whosthedoctor/Open-Source-Chemical-Reactor/docs/cube-face-template-gasket.png

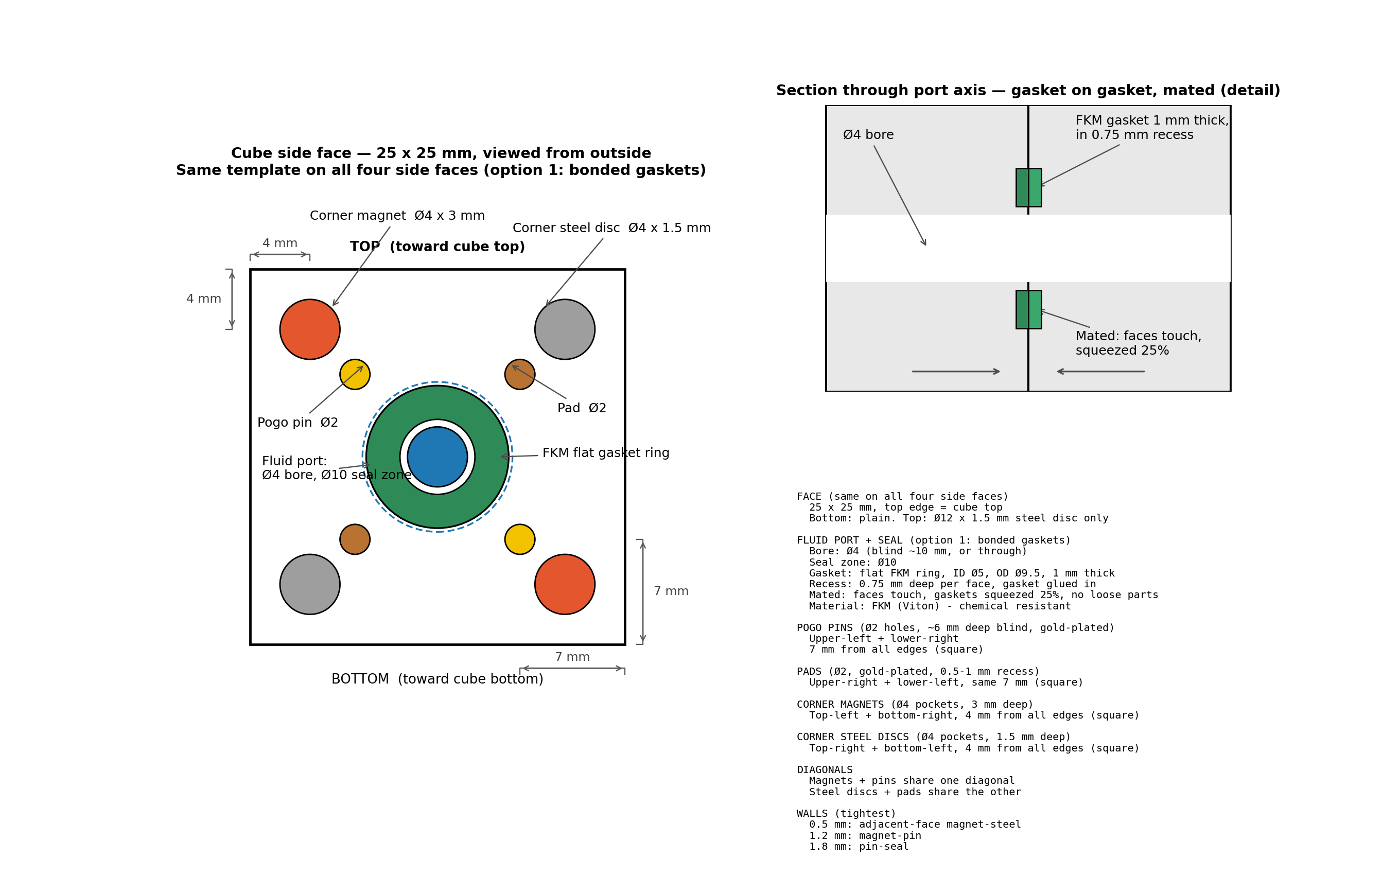
docs/cube-face-template-gasket.png
