whosthedoctor/Open-Source-Chemical-Reactor/BOM.csv

component | quantity | unit_price_usd | link | notes
Ender 3 (used - motion gantry) | 1 | 0.00 | https://www.ebay.com/sch/i.html?_nkw=creality+ender+3 | ALREADY OWNED (confirmed Oct 2026) - $200 if you need to buy one. PSU is included with the printer, no separate PSU needed
Bambu Lab PETG Translucent filament (cube structure) | 2 | 18.99 | https://www.bestbuy.com/product/bambu-lab-1-75mm-petg-translucent-filament-clear/CZTZV9ZPZH/sku/6610619 | Price at Best Buy checked Oct 2026
Spring-loaded pogo pins gold-plated (pack of 100) | 1 | 15.00 | https://www.amazon.com/s?k=gold+spring+loaded+pogo+pins | Power/signal interconnects between cubes
Neodymium disc magnets (pack of 100) | 1 | 15.00 | https://www.amazon.com/s?k=small+neodymium+disc+magnets | Self-aligning cube snap
PTFE tubing 2mm ID x 4mm OD 5m (wetted fluid path + bore sleeves) | 1 | 15.00 | https://www.amazon.com/s?k=ptfe+tubing+2mm+id | 2mm ID x 4mm OD. One sleeve per fluid bore, cut flush at the face: 10mm for a blind bore, 25mm for a through bore. 5m covers sleeves for 20 cubes plus pump/valve plumbing
FKM O-ring 5 x 1.5mm (fluid face seals) | 1 | 11.00 | https://oringsandmore.com/fkm-o-ring-5-x-1-5mm-minimum-15-pcs/ | 75-durometer FKM (OringsandMore SKU 515MMV), min 15 pcs: $1.05 + $9.95 USPS First Class = $11.00 delivered; one ring per mated pair, groove ID 5.5mm / OD 9.5mm, 0.6mm deep per face; price/shipping from product page Oct 2026, re-confirm at checkout
Peltier modules TEC1-12706 (Peltier cubes) | 4 | 7.50 | https://www.amazon.com/s?k=tec1-12706 | 12V part - driven via MOSFET module from dedicated 24V->12V buck rail (hybrid rail decision 2026-10-24); HB output unused for Peltier
Heater cartridges 24V 40W 6x20mm ceramic (heater cubes) | 1 | 15.49 | https://www.walmart.com/ip/16147002771 | Pack of 6 (5 needed + 1 spare) - 24V cartridges match HE0/HE1 at 24V VIN, no buck needed for heaters (hybrid rail decision 2026-10-24)
NTC 100K thermistors for heater cubes | 1 | 6.00 | https://www.amazon.com/s?k=100k+ntc+thermistor+3950 | Estimate - heater cube temperature sensing (TH0/TH1)
24V to 12V buck converter 10A with fuse (Peltier rail) | 1 | 16.79 | https://www.walmart.com/ip/18121103298 | Dedicated 12V rail for the Peltier only - sized for one Peltier cube at a time (6A max draw)
MOSFET trigger switch modules (Peltier + valves/vacuum/LEDs) | 1 | 8.69 | https://www.walmart.com/ip/17434554288 | Pack of 4 - logic-level PC13/EXP pins switch 12V loads; covers Peltier + all valve/LED outputs
12V DC peristaltic dosing pumps | 2 | 10.00 | https://www.amazon.com/s?k=12v+peristaltic+dosing+pump | Run from CNC fan outputs jumpered to 12V (1A/port max, 2.5A total)
12V 2-way solenoid valves (fluid routing) | 2 | 9.00 | https://www.amazon.com/s?k=12v+2-way+solenoid+valve | Driven via EXP logic pins + external MOSFET module (only 2 CNC fan outputs on M5P)
pH probe + DS18B20 temp probes + calibration buffers (sensor cube) | 1 | 40.00 | https://www.amazon.com/s?k=ph+probe+module+ds18b20+calibration+buffer | Sold as a kit
BIGTREETECH Manta M5P V1.0 mainboard (5-axis - Klipper) | 1 | 52.99 | https://west3d.com/products/btt-manta-m5p-klipper-controller-board-3d-printer-control-system-using-cb1-cm4 | Board only - drivers separate. CNC fan outputs jumper-selectable 5/12/24V (manual-verified)
TMC2209 stepper drivers | 5 | 9.00 | https://www.amazon.com/s?k=tmc2209+stepper+driver | X/Y/Z + grabber rotate + grabber lift
BIGTREETECH CB1 (Klipper host - mounts on M5P) | 1 | 53.89 | https://www.newegg.com/p/3C6-037R-00035 | Host confirmed 2026-10-24 - M5P requires a CM4-form-factor host on the BTB headers
uxcell 605ZZ bearings 5x14x5mm (pack of 20) | 1 | 9.00 | https://www.amazon.com/s?k=uxcell+605ZZ+5x14x5mm+pack+of+20 | Price estimate - verify at checkout; exact 20-pack not price-verified (5-pack found at $10.49)
BNTECHGO 28 AWG silicone wire red/black 50ft | 1 | 21.64 | https://mastergripshop.com/products/b07hgt77r5 | Signal/sensor/endstop wiring ONLY - too thin for heater/Peltier power runs
Silicone wire 18 AWG for heater/Peltier power runs | 1 | 12.00 | https://www.amazon.com/s?k=18+awg+silicone+wire+red+black | Estimate - 28 AWG cannot carry 3.3A+ heater currents
HESAI mechanical endstop switches with cable (pack of 6) | 1 | 12.00 | https://www.amazon.com/s?k=HESAI+3D+printer+endstop+limit+switch+pack+of+6 | Price estimate - verify; X/Y/Z endstops + spares
STEPPERONLINE NEMA 11 stepper motor 0.67A (grabber motors) | 2 | 11.32 | https://s.click.aliexpress.com/deep_link.htm | Catalog variant is 7Ncm; your spec is 6Ncm/8.5oz-in - confirm shaft/variant
Head magnet - disc magnet 14mm x 3mm (pack of 20) | 1 | 16.99 | https://themagnetbaron.com/products/20pcs-5-8-x-1-8-14mm-x-3mm-disc-magnets?variant=30753395310676 | Magnet head - 1 needed, 19 spares
Corner magnets - disc magnet 4mm x 3mm (pack of 100) | 1 | 16.99 | https://wargameportal.com/products/100pcs-4mm-x-3mm-5-32-x-1-8-disc-magnets?variant=49647373320470 | 2 per cube (diagonal) - 40 for 20 cubes + spares
Cube-top steel discs 12mm x 1.5mm (pack of 20) | 1 | 9.00 | https://www.amazon.com/s?k=steel+disc+12mm | Estimate - verify; 1 per cube - magnet-head pickup target
Corner steel discs 4mm x 1.5mm (pack of 100) | 1 | 8.00 | https://www.amazon.com/s?k=steel+disc+4mm | Estimate - verify; 2 per cube (diagonal, opposite the corner magnets)
TMC2209 stepper drivers (spares) | 2 | 9.00 | https://www.amazon.com/s?k=tmc2209+stepper+driver | Spare drivers - a shorted motor wire kills a driver; 5 in use, 2 spares
Peltier module TEC1-12706 (spare) | 1 | 7.50 | https://www.amazon.com/s?k=tec1-12706 | Spare Peltier - thermal-cycling failures; 4 in use
2-part epoxy syringe (sleeve retention) | 1 | 7.00 | https://www.amazon.com/s?k=2+part+epoxy+syringe | Estimate - verify. Dab on the sleeve OD at the inner end, inside the cube and out of the fluid path; also usable for potting face magnets
Shipping (consolidated estimate across vendors) | 1 | 35.00 |  | Stardance requires prices including shipping - TOTAL: $596.59 (Ender 3 already owned; host = CB1; hybrid heater rail: 24V cartridges + 12V Peltier on buck/MOSFET; magnet head; includes spares: 2x TMC2209 + 1x Peltier; PTFE bore sleeves + epoxy; FKM seal line booked at $11.00 delivered - if that $9.95 OringsandMore shipping is already inside this $35 estimate | total is $586.64)
