whosthedoctor/Open-Source-Chemical-Reactor/CAD/6-way_connector.step

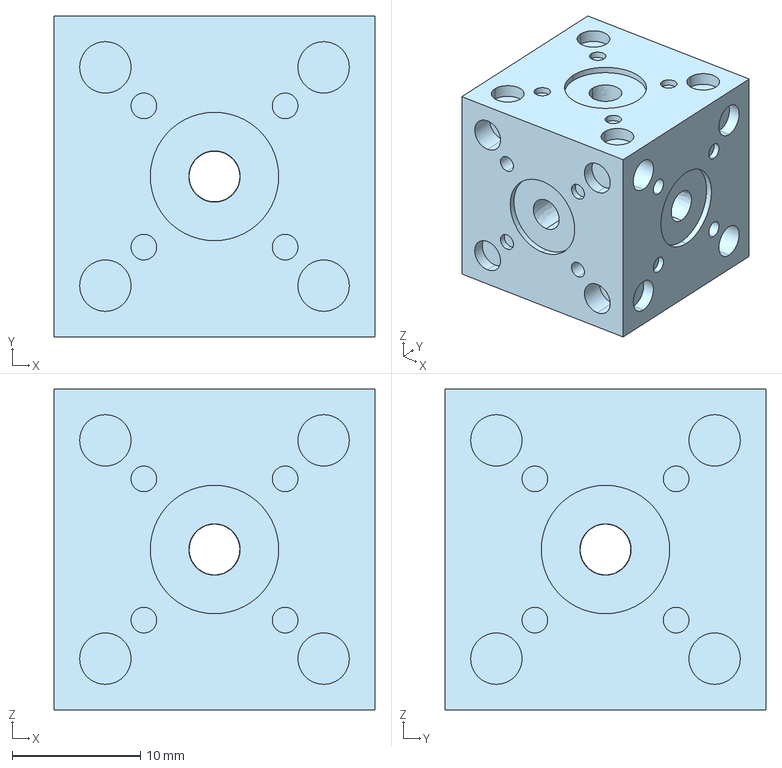
[picture p3: CAD file, 2026-10-27]
CAD/6-way_connector.step
25.0 x 25.0 x 25.0 mm
