whosthedoctor/Open-Source-Chemical-Reactor/CAD/Hotbed_Steel_Disc_Cover.step

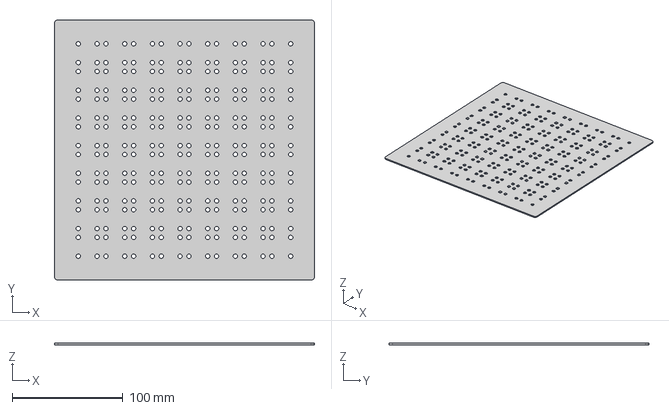
[picture p4: CAD file, 2026-10-27]
CAD/Hotbed_Steel_Disc_Cover.step
235.0 x 235.0 x 1.50 mm
