whosthedoctor/Open-Source-Chemical-Reactor/CAD/carriage grabber - Part 9.step

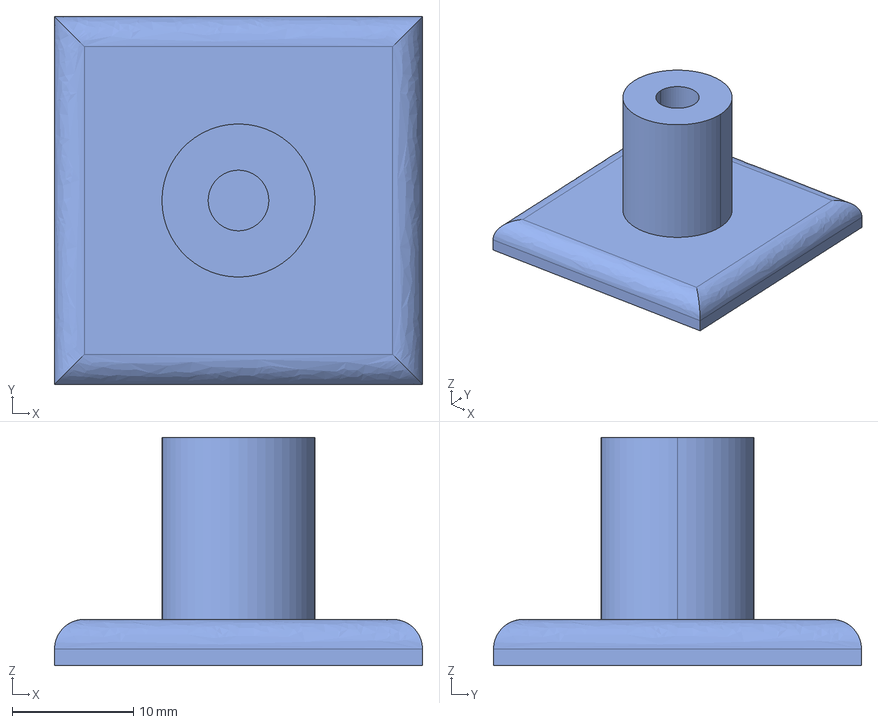
[picture p5: CAD file, 2026-10-27]
CAD/carriage grabber - Part 9.step
30.3 x 30.3 x 18.8 mm
