whosthedoctor/Open-Source-Chemical-Reactor/CAD/carriage grabber - Part 8.step

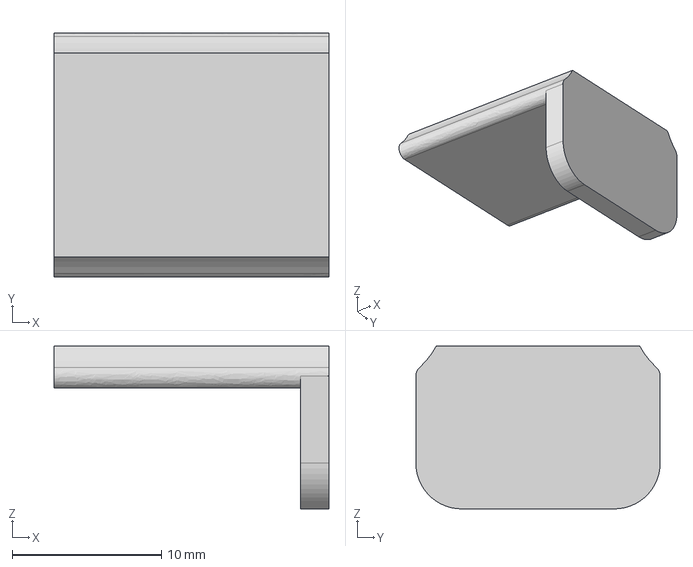
[picture p6: CAD file, 2026-10-27]
CAD/carriage grabber - Part 8.step
18.4 x 16.4 x 10.9 mm
