whosthedoctor/Open-Source-Chemical-Reactor/CAD/carriage grabber - Part 7.step

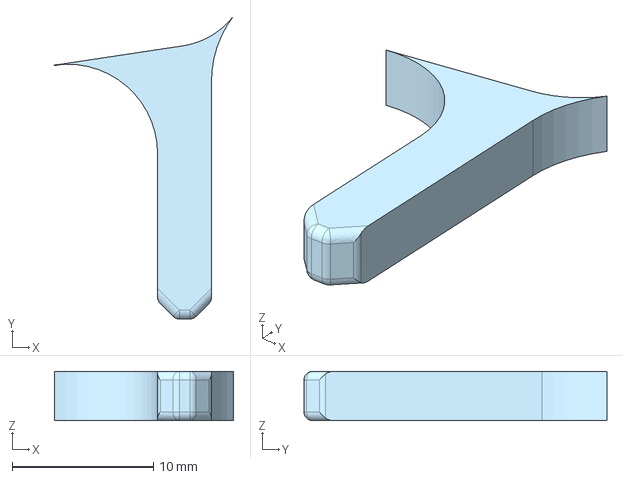
[picture p7: CAD file, 2026-10-27]
CAD/carriage grabber - Part 7.step
12.7 x 21.4 x 3.50 mm
