whosthedoctor/Open-Source-Chemical-Reactor/CAD/carriage grabber - Part 6.step

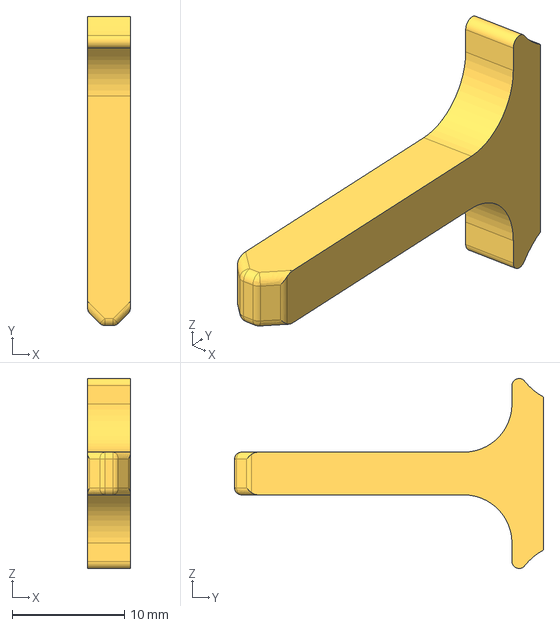
[picture p8: CAD file, 2026-10-27]
CAD/carriage grabber - Part 6.step
3.81 x 27.5 x 16.9 mm
