whosthedoctor/Open-Source-Chemical-Reactor/CAD/carriage grabber - Part 5.step

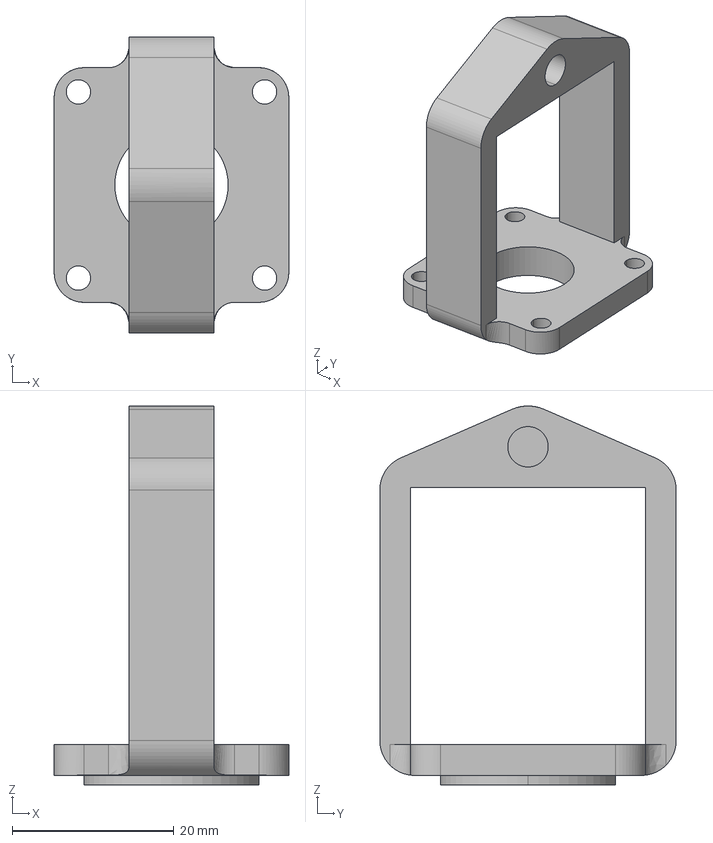
[picture p9: CAD file, 2026-10-27]
CAD/carriage grabber - Part 5.step
29.0 x 36.6 x 46.8 mm
