whosthedoctor/Open-Source-Chemical-Reactor/CAD/carriage grabber - Part 4.step

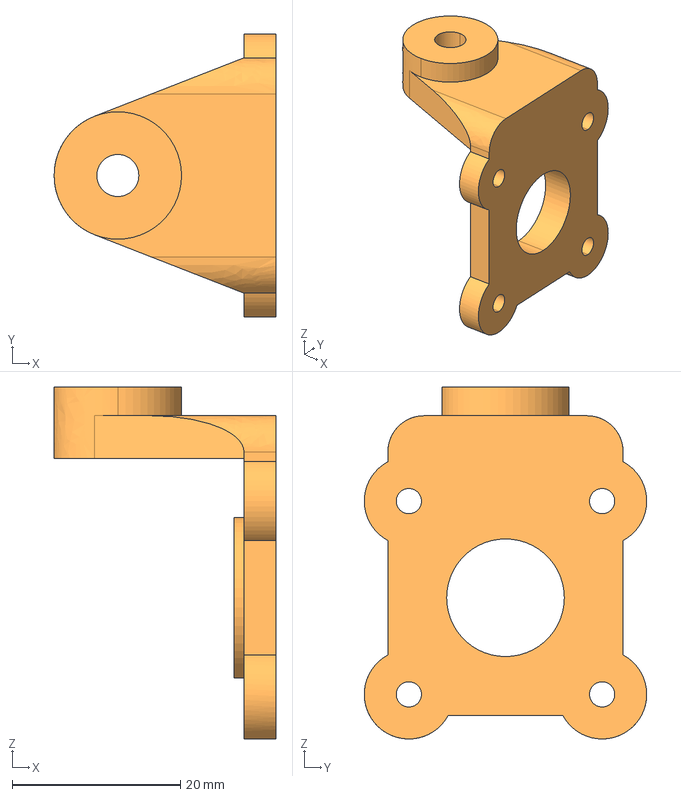
[picture p10: CAD file, 2026-10-27]
CAD/carriage grabber - Part 4.step
26.4 x 33.6 x 41.9 mm
