whosthedoctor/Open-Source-Chemical-Reactor/CAD/carriage grabber - Part 3.step

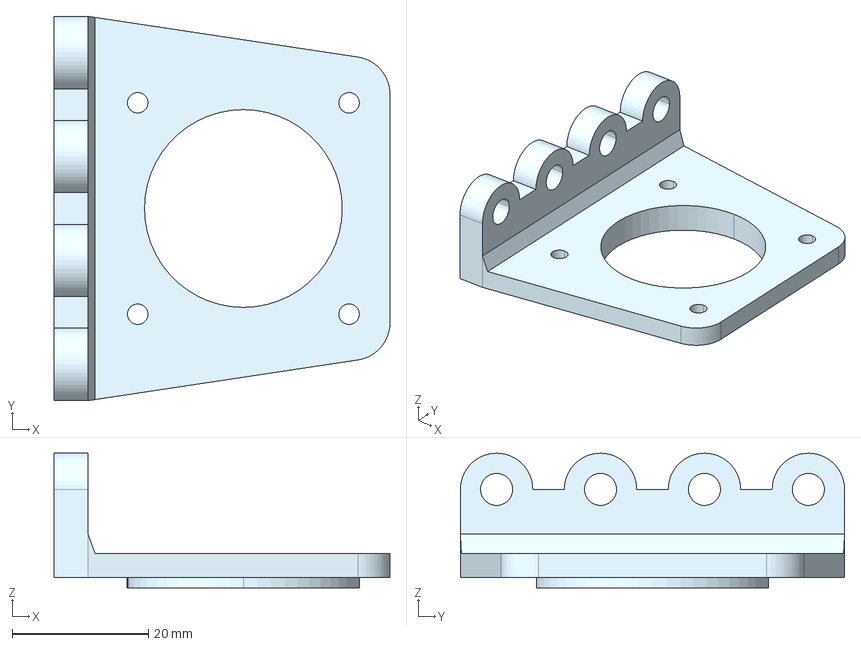
[picture p11: CAD file, 2026-10-27]
CAD/carriage grabber - Part 3.step
49.3 x 56.3 x 19.7 mm
