whosthedoctor/Open-Source-Chemical-Reactor/CAD/carriage grabber - Part 2.step

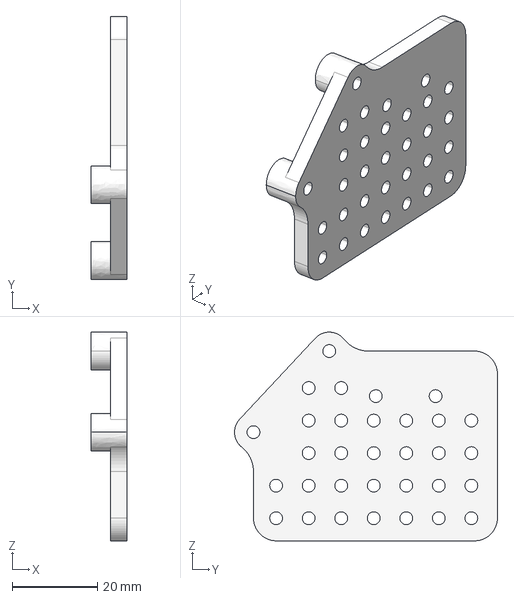
[picture p12: CAD file, 2026-10-27]
CAD/carriage grabber - Part 2.step
8.32 x 61.6 x 48.9 mm
