whosthedoctor/Open-Source-Chemical-Reactor/(commit log)

2026-10-05 Revise README with detailed project specifications
    Expanded the project description with detailed specifications for the modular chemical reactor, including types of cubes, materials, and example processes.
2026-10-23 Add image description for Ender3 Extruder gantry
    Added a description for the image of the gantry related to the Ender3 Extruder.
2026-10-23 Remove extra CAD files
2026-10-23 Add carriage grabber CAD files
    [carriage grabber - Part 10.step]
2026-10-24 Add BOM with links and prices
    [BOM.csv]
2026-10-24 Add Klipper config for Octopus Pro controller
    [printer.cfg]
2026-10-24 Add wiring diagram
2026-10-24 Ender 3 already owned - zero the printer line
    [BOM.csv]
2026-10-24 Add files/wiring/safety sections + open-cube note
2026-10-24 Swap controller to Manta M5P + add decided parts
    [BOM.csv]
2026-10-24 Swap Klipper config to Manta M5P pin map
    [printer.cfg]
2026-10-24 Redraw wiring diagram for Manta M5P
2026-10-24 Hybrid heater rail: 24V cartridges + 12V Peltier on buck/MOSFET; host CB1 confirmed
    [BOM.csv]
2026-10-24 Peltier to PC13/MOSFET on buck rail; heaters 24V; host CB1 confirmed
    [printer.cfg]
2026-10-24 Wiring diagram: CB1 host + hybrid heater rail
2026-10-24 Magnet head: add head/corner magnets + steel discs
    [BOM.csv]
2026-10-24 Magnet head: rotation/lift notes + PICK_CUBE description
    [printer.cfg]
2026-10-24 Wiring diagram: magnet head labels
2026-10-24 Add magnet head design + cube face template
2026-10-25 Point README Files section at current 4/7 face template diagram
2026-10-26 BOM: add spares (2x TMC2209, 1x Peltier) - total $590.59
    [BOM.csv]
2026-10-27 CAD: replace with current Onshape additional parts (cube, bed cover, carriage arm Parts 2-9)
    [carriage grabber - Part 2.step]
2026-10-27 Remove superseded carriage grabber Part 10 (not in current Onshape studio)
    [carriage grabber - Part 10.step]
2026-10-27 README: update CAD/ line for the new Onshape additional parts
2026-10-27 BOM: specify PTFE tube 2x4mm for bore sleeves, add 2-part epoxy retention; total $597.59
    [BOM.csv]
2026-10-27 README: PTFE bore sleeve method, FKM gaskets in Materials
2026-10-27 docs: full-assembly screenshot
2026-10-27 README: full-assembly screenshot as top image, CAD line + stock Ender 3 credit
2026-10-27 CAD: full reactor assembly STEP (zipped, 48MB raw)
2026-10-27 README: full assembly now in CAD as zipped STEP
2026-10-29 BOM: sized FKM seal line (loose 5x1.5mm O-ring, OringsandMore) replaces EPDM placeholder; total $596.59
    [BOM.csv]
